bmc0/lm3886_amp_balanced_input/lm3886_amp_balanced_input/lm3886_amp_balanced_input.pdf

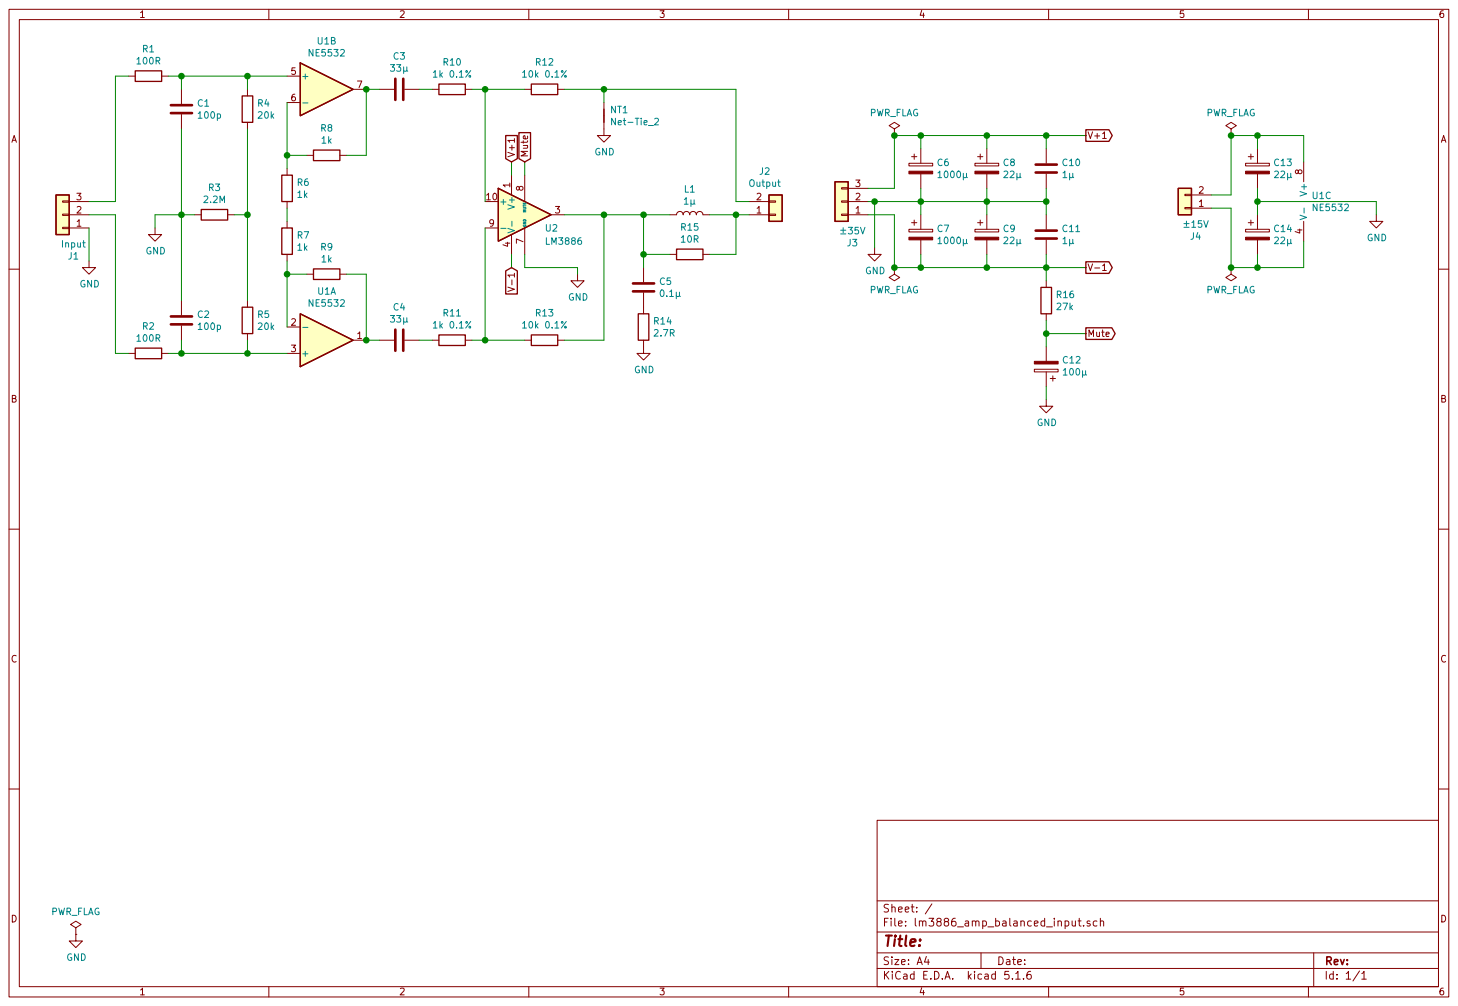
[picture p1: page 1]
