bmc0/lm3886_amp_balanced_input/lm3886_psu/lm3886_psu.pdf

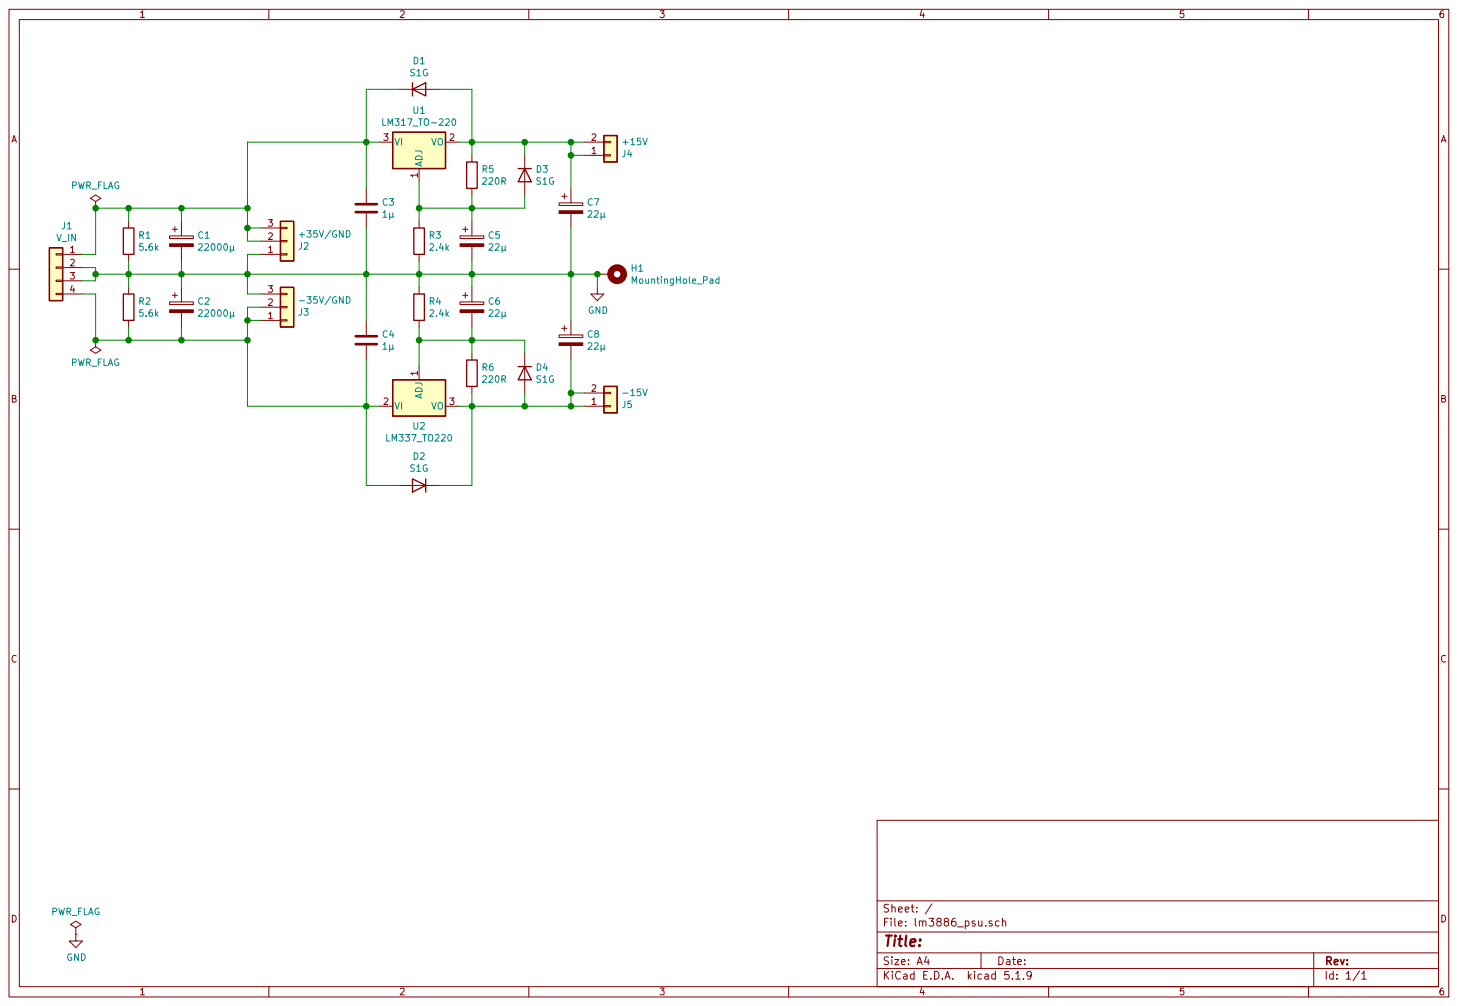
[picture p2: page 1]
