bmc0/lm3886_amp_balanced_input/lm3886_psu_4ch/lm3886_psu_4ch.pdf

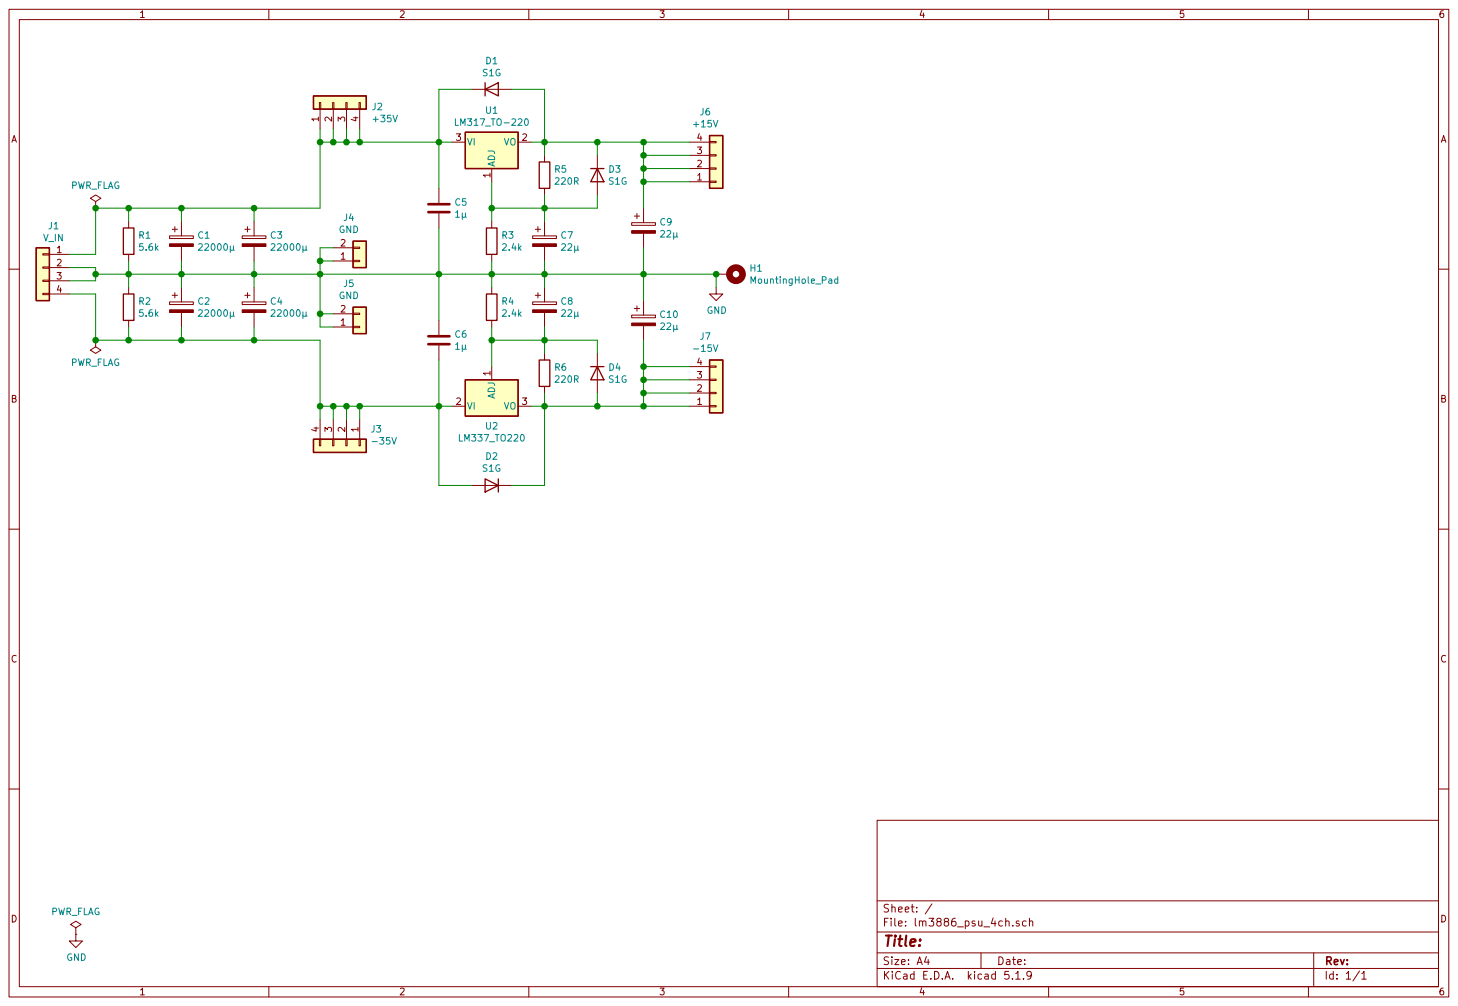
[picture p3: page 1]
