bmc0/lm3886_amp_balanced_input/lm3886_soft_start_v2/lm3886_soft_start_v2.pdf

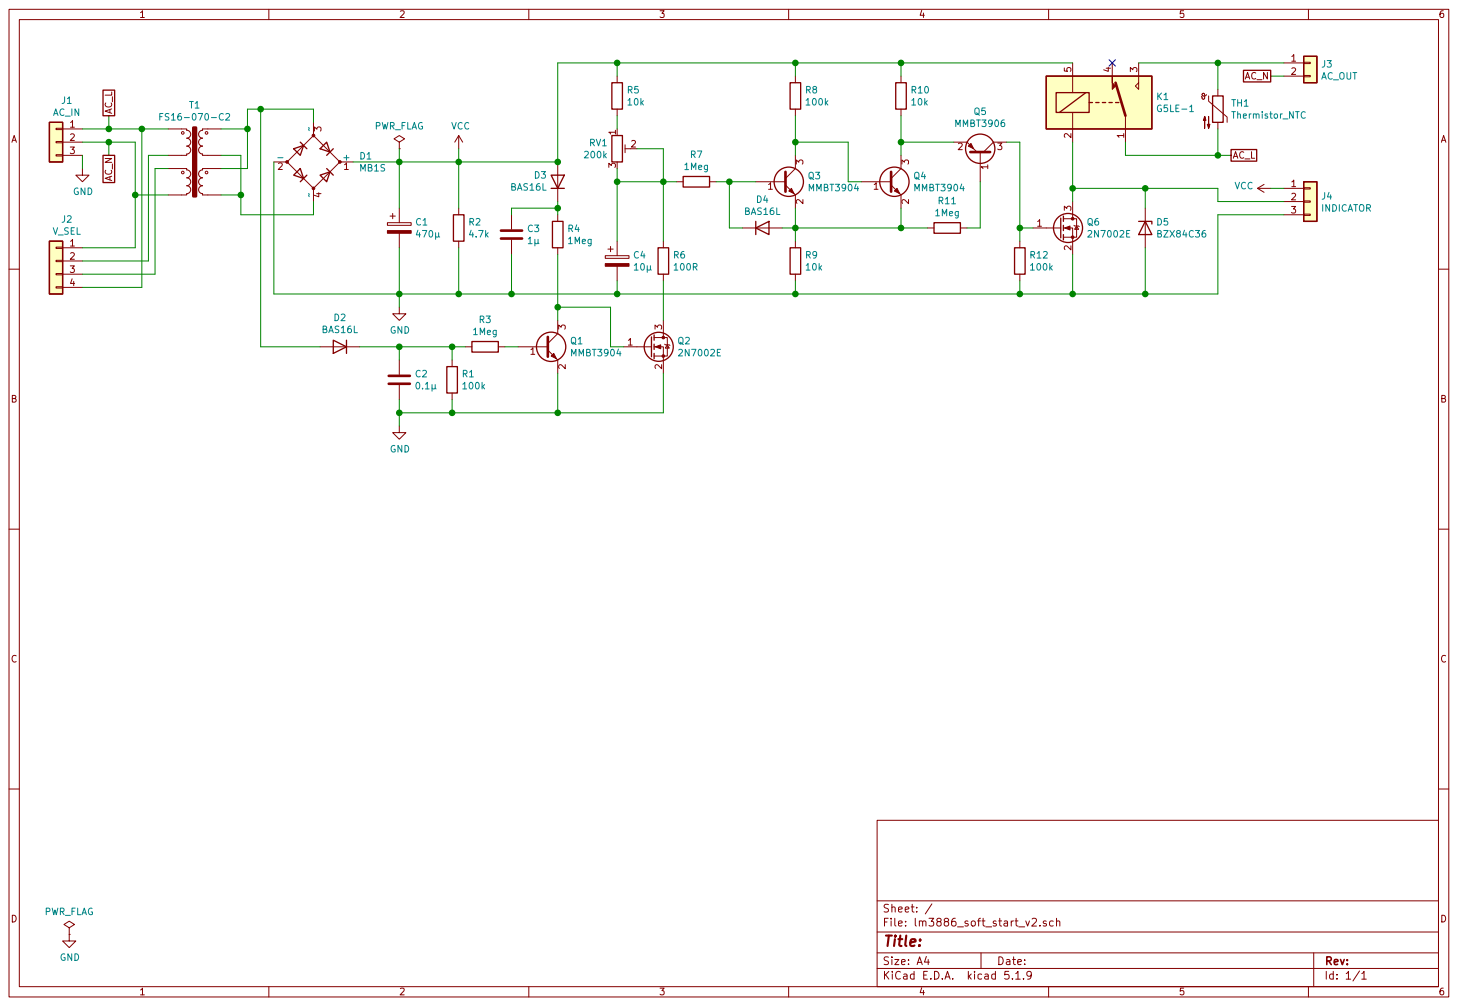
[picture p4: page 1]
