bmc0/lm3886_amp_balanced_input/lm3886_soft_start_v2/lm3886_soft_start_v2.kicad_pcb

## KiCad design lm3886_soft_start_v2/lm3886_soft_start_v2.kicad_pcb (2021-04-19)

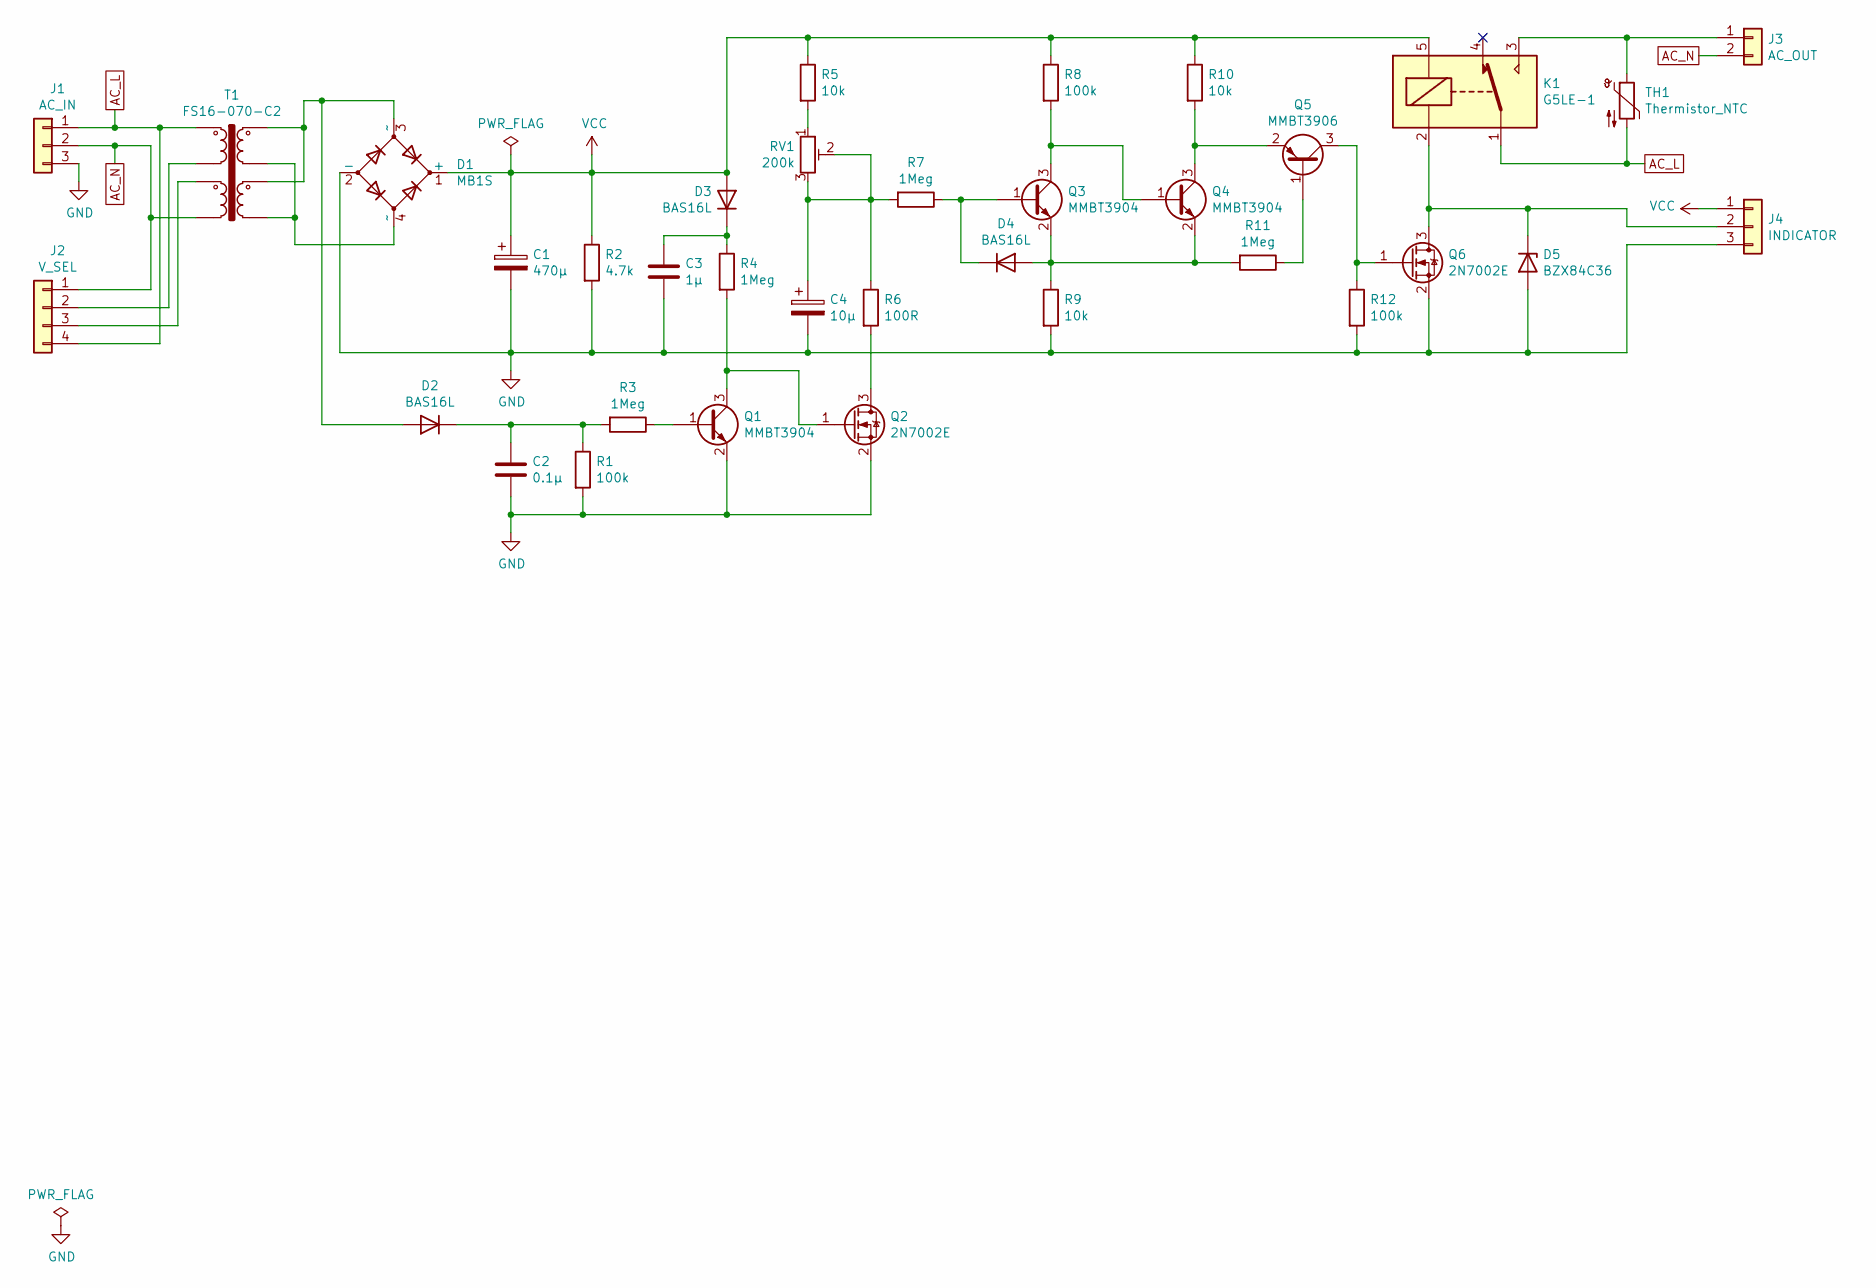
[picture p8: schematic lm3886_soft_start_v2.sch]

Parts:
C1: 470µ; CP_Radial_D10.0mm_P5.00mm
C2: 0.1µ; C_0603_1608Metric
C3: 1µ; C_0805_2012Metric
C4: 10µ; CP_Radial_D5.0mm_P2.00mm
D1: MB1S; TO-269AA
D2, D3, D4: BAS16L; D_SOT-23_ANK
D5: BZX84C36; D_SOT-23_ANK
J1: AC_IN; TerminalBlock_Phoenix_PT-1,5-3-5.0-H_1x03_P5.00mm_Horizontal
J2: V_SEL; SolderWire-0.5sqmm_1x04_P4.6mm_D0.9mm_OD2.1mm
J3: AC_OUT; TerminalBlock_Phoenix_PT-1,5-2-5.0-H_1x02_P5.00mm_Horizontal
J4: INDICATOR; PinHeader_1x03_P2.54mm_Vertical
K1: G5LE-1; Relay_SPDT_Omron-G5LE-1
Q1, Q3, Q4: MMBT3904; SOT-23
Q2, Q6: 2N7002E; SOT-23
Q5: MMBT3906; SOT-23
R1, R8, R12: 100k; R_0603_1608Metric
R2: 4.7k; R_1206_3216Metric
R3, R4, R7, R11: 1Meg; R_0603_1608Metric
R5, R9, R10: 10k; R_0603_1608Metric
R6: 100R; R_0603_1608Metric
RV1: 200k; Potentiometer_Nidec_Copal_CT-6EP
T1: FS16-070-C2; Triad_FS16-070-C2
TH1: Thermistor_NTC; NTC_Thermistor_D16mm_P7.5mm

Connections:
AC_L: J1.1, J2.4, K1.1, T1.1, TH1.2
AC_N: J1.2, J2.1, J3.2, T1.4
GND: C1.2, C2.2, C3.2, C4.2, D1.2 (-), D5.2 (A), J1.3, J4.3, Q1.2 (E), Q2.2 (S), Q6.2 (S), R1.2, R2.2, R9.2, R12.2
unnamed: C2.1, D2.1 (K), R1.1, R3.2
unnamed: C3.1, D3.1 (K), R4.1
unnamed: C4.1, R6.1, R7.2, RV1.2, RV1.3
unnamed: D1.3 (~~), D2.2 (A), T1.5, T1.7
unnamed: D1.4 (~~), T1.6, T1.8
unnamed: D4.1 (K), Q3.1 (B), R7.1
unnamed: D4.2 (A), Q3.2 (E), Q4.2 (E), R9.1, R11.2
unnamed: D5.1 (K), J4.2, K1.2, Q6.3 (D)
unnamed: J2.2, T1.2
unnamed: J2.3, T1.3
unnamed: J3.1, K1.3, TH1.1
unnamed: Q1.1 (B), R3.1
unnamed: Q1.3 (C), Q2.1 (G), R4.2
unnamed: Q2.3 (D), R6.2
unnamed: Q3.3 (C), Q4.1 (B), R8.2
unnamed: Q4.3 (C), Q5.2 (E), R10.2
unnamed: Q5.1 (B), R11.1
unnamed: Q5.3 (C), Q6.1 (G), R12.1
unnamed: R5.2, RV1.1
VCC: C1.1, D1.1 (+), D3.2 (A), J4.1, K1.5, R2.1, R5.1, R8.1, R10.1

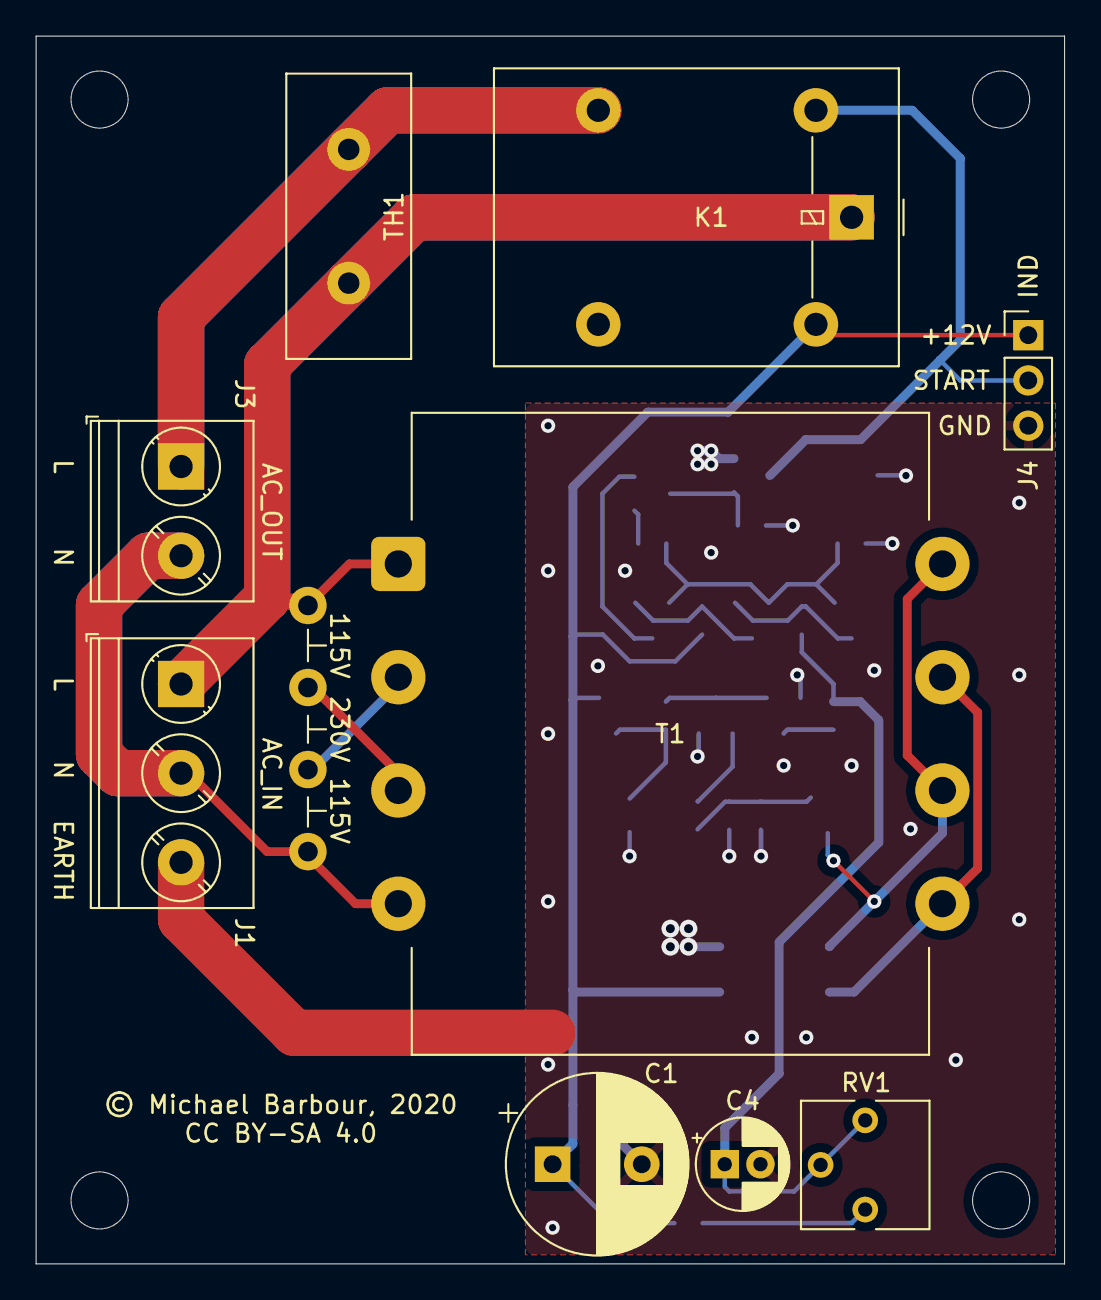
[picture p9: board lm3886_soft_start_v2.kicad_pcb from above]

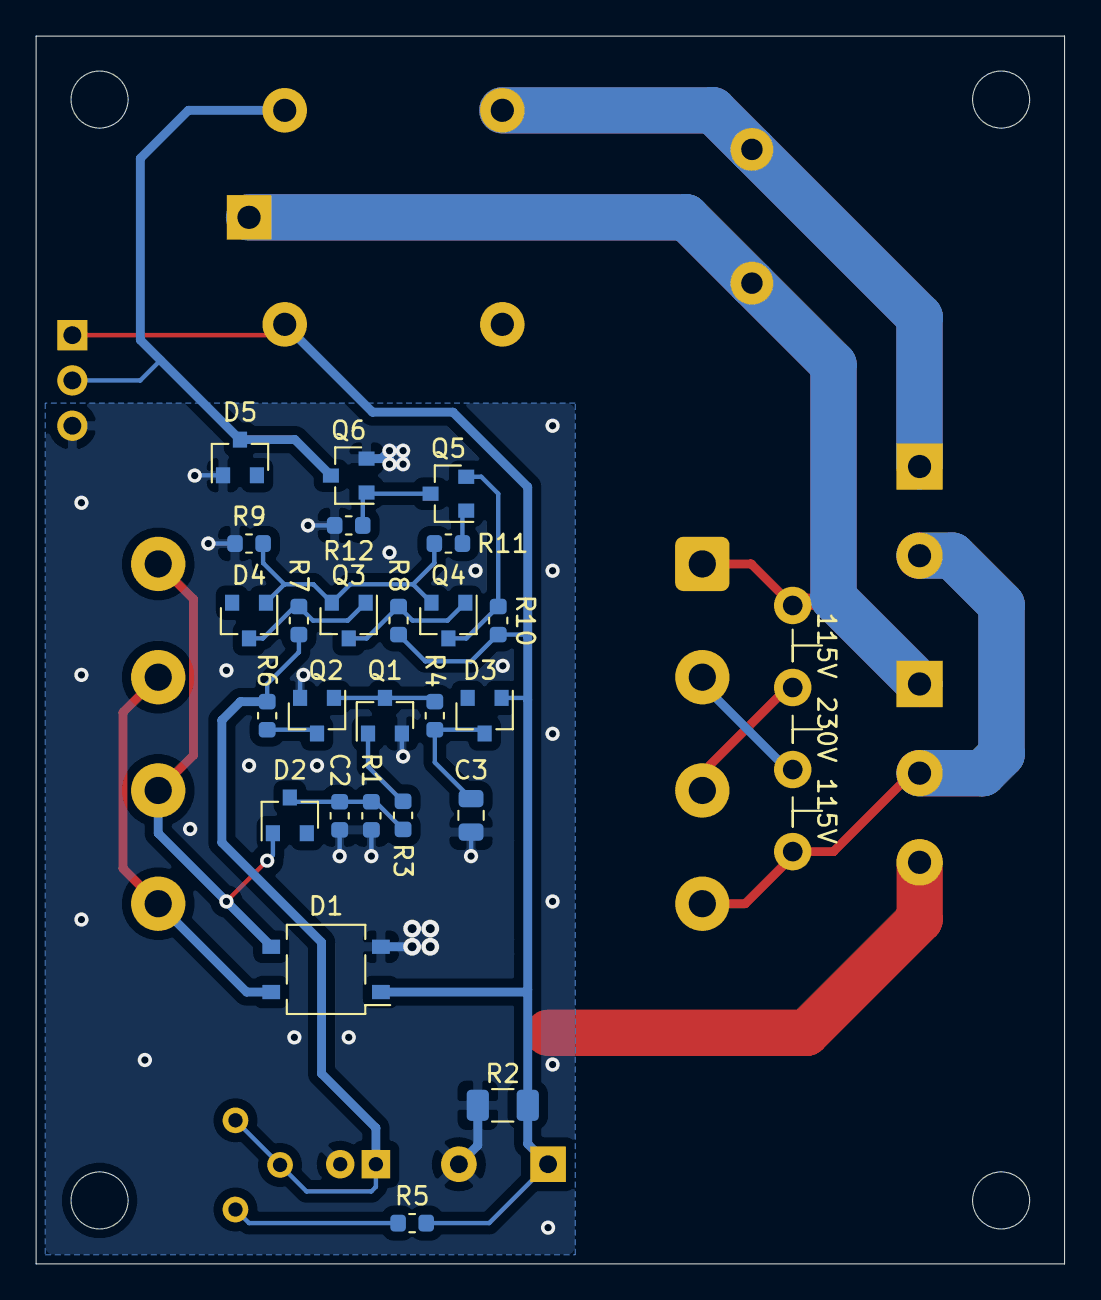
[picture p10: board lm3886_soft_start_v2.kicad_pcb from below]

Board: 2 copper layers, 57.7 x 68.8 mm, 35 parts (25 on the bottom side), 23 nets.
