bmc0/lm3886_amp_balanced_input/lm3886_psu/lm3886_psu.kicad_pcb

## KiCad design lm3886_psu/lm3886_psu.kicad_pcb (2021-04-19)

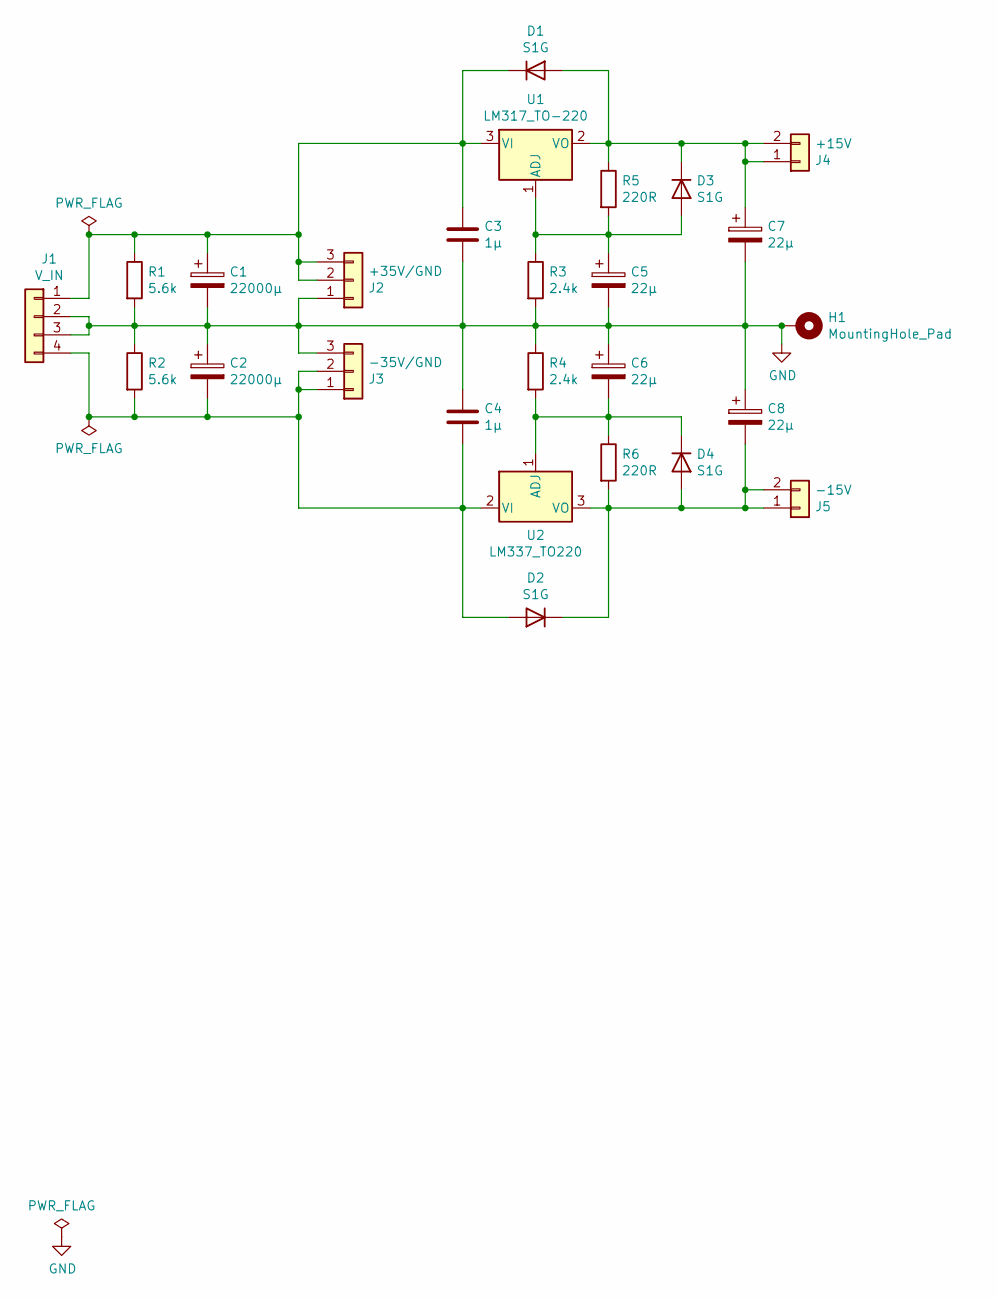
[picture p11: schematic lm3886_psu.sch]

Parts:
C1, C2: 22000µ; CP_Radial_D35.0mm_P10.00mm_SnapIn
C3, C4: 1µ; C_1206_3216Metric
C5, C6, C7, C8: 22µ; CP_Radial_D5.0mm_P2.00mm
D1, D2, D3, D4: S1G; D_SMA
H1: MountingHole_Pad; MountingHole_3.2mm_M3_Pad_Via
J1: V_IN; TerminalBlock_Phoenix_PT-1,5-4-5.0-H_1x04_P5.00mm_Horizontal
J2: +35V/GND; TerminalBlock_Phoenix_PT-1,5-3-5.0-H_1x03_P5.00mm_Horizontal
J3: -35V/GND; TerminalBlock_Phoenix_PT-1,5-3-5.0-H_1x03_P5.00mm_Horizontal
J4: +15V; TerminalBlock_Phoenix_PT-1,5-2-3.5-H_1x02_P3.50mm_Horizontal
J5: -15V; TerminalBlock_Phoenix_PT-1,5-2-3.5-H_1x02_P3.50mm_Horizontal
R1, R2: 5.6k; R_Axial_DIN0411_L9.9mm_D3.6mm_P15.24mm_Horizontal
R3, R4: 2.4k; R_1206_3216Metric
R5, R6: 220R; R_1206_3216Metric
U1: LM317_TO-220; TO-220-3_Vertical
U2: LM337_TO220; TO-220-3_Vertical

Connections:
GND: C1.2, C2.1, C3.2, C4.1, C5.2, C6.1, C7.2, C8.1, H1.1, J1.2, J1.3, J2.1, J3.3, R1.2, R2.1, R3.2, R4.1
unnamed: C1.1, C3.1, D1.1 (K), J1.1, J2.2, J2.3, R1.1, U1.3 (VI)
unnamed: C2.2, C4.2, D2.2 (A), J1.4, J3.1, J3.2, R2.2, U2.2 (VI)
unnamed: C5.1, D3.2 (A), R3.1, R5.2, U1.1 (ADJ)
unnamed: C6.2, D4.1 (K), R4.2, R6.1, U2.1 (ADJ)
unnamed: C7.1, D1.2 (A), D3.1 (K), J4.1, J4.2, R5.1, U1.2 (VO)
unnamed: C8.2, D2.1 (K), D4.2 (A), J5.1, J5.2, R6.2, U2.3 (VO)

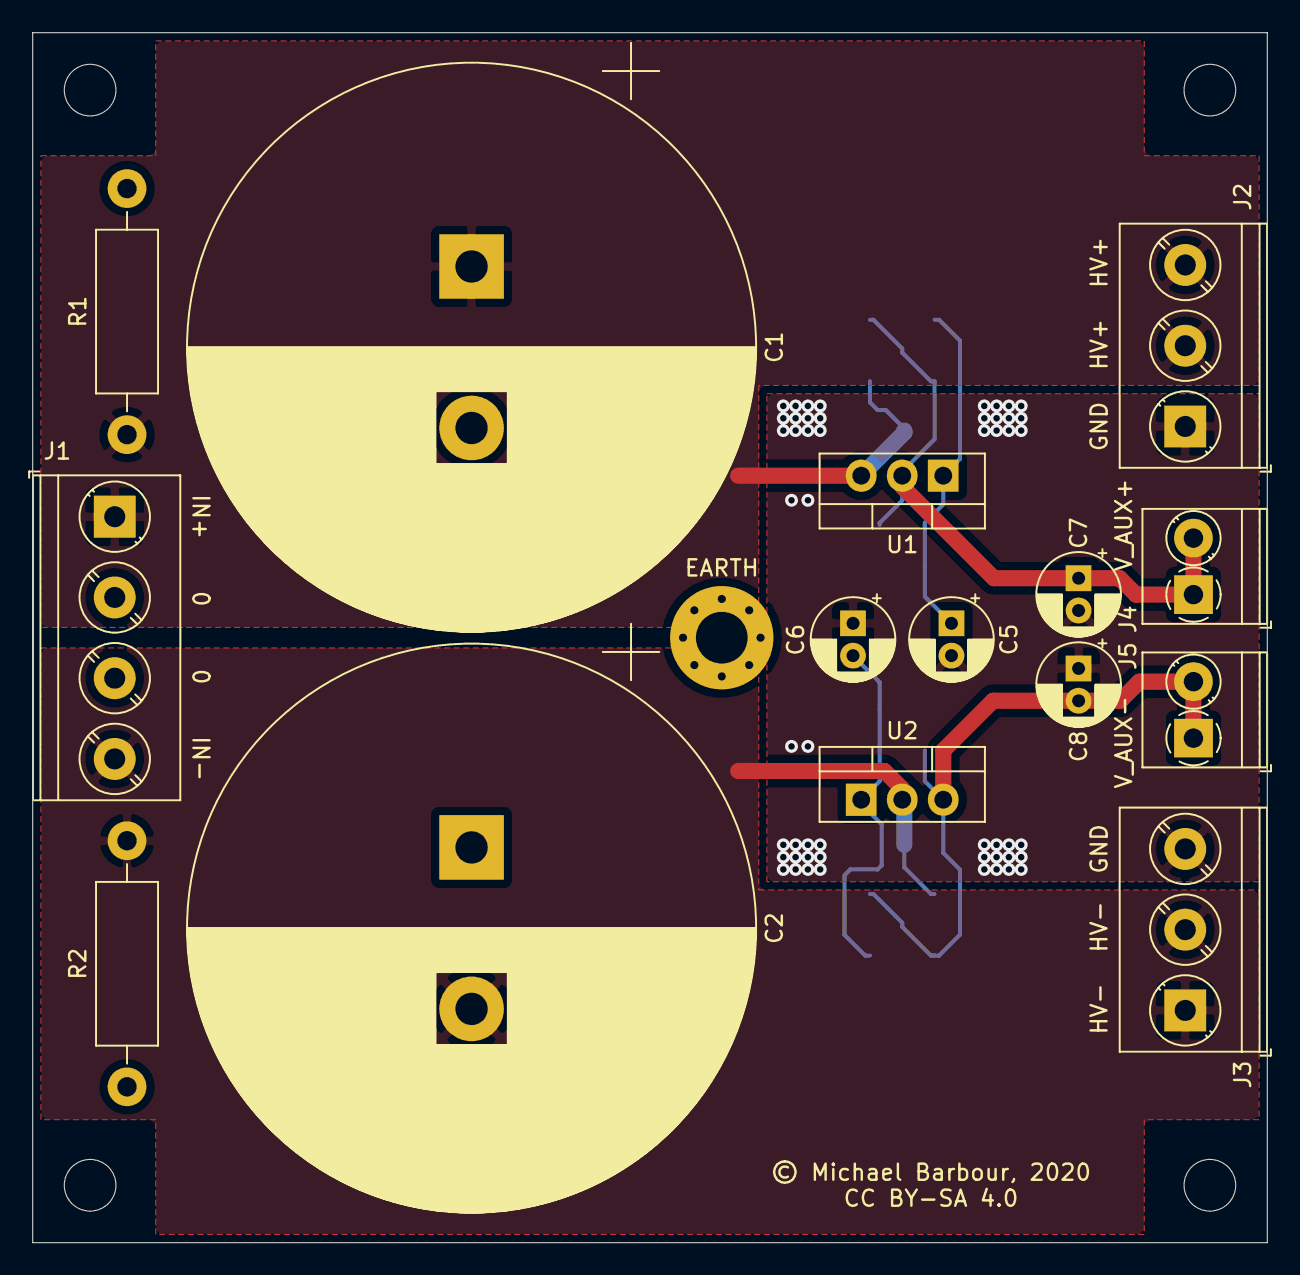
[picture p12: board lm3886_psu.kicad_pcb from above]

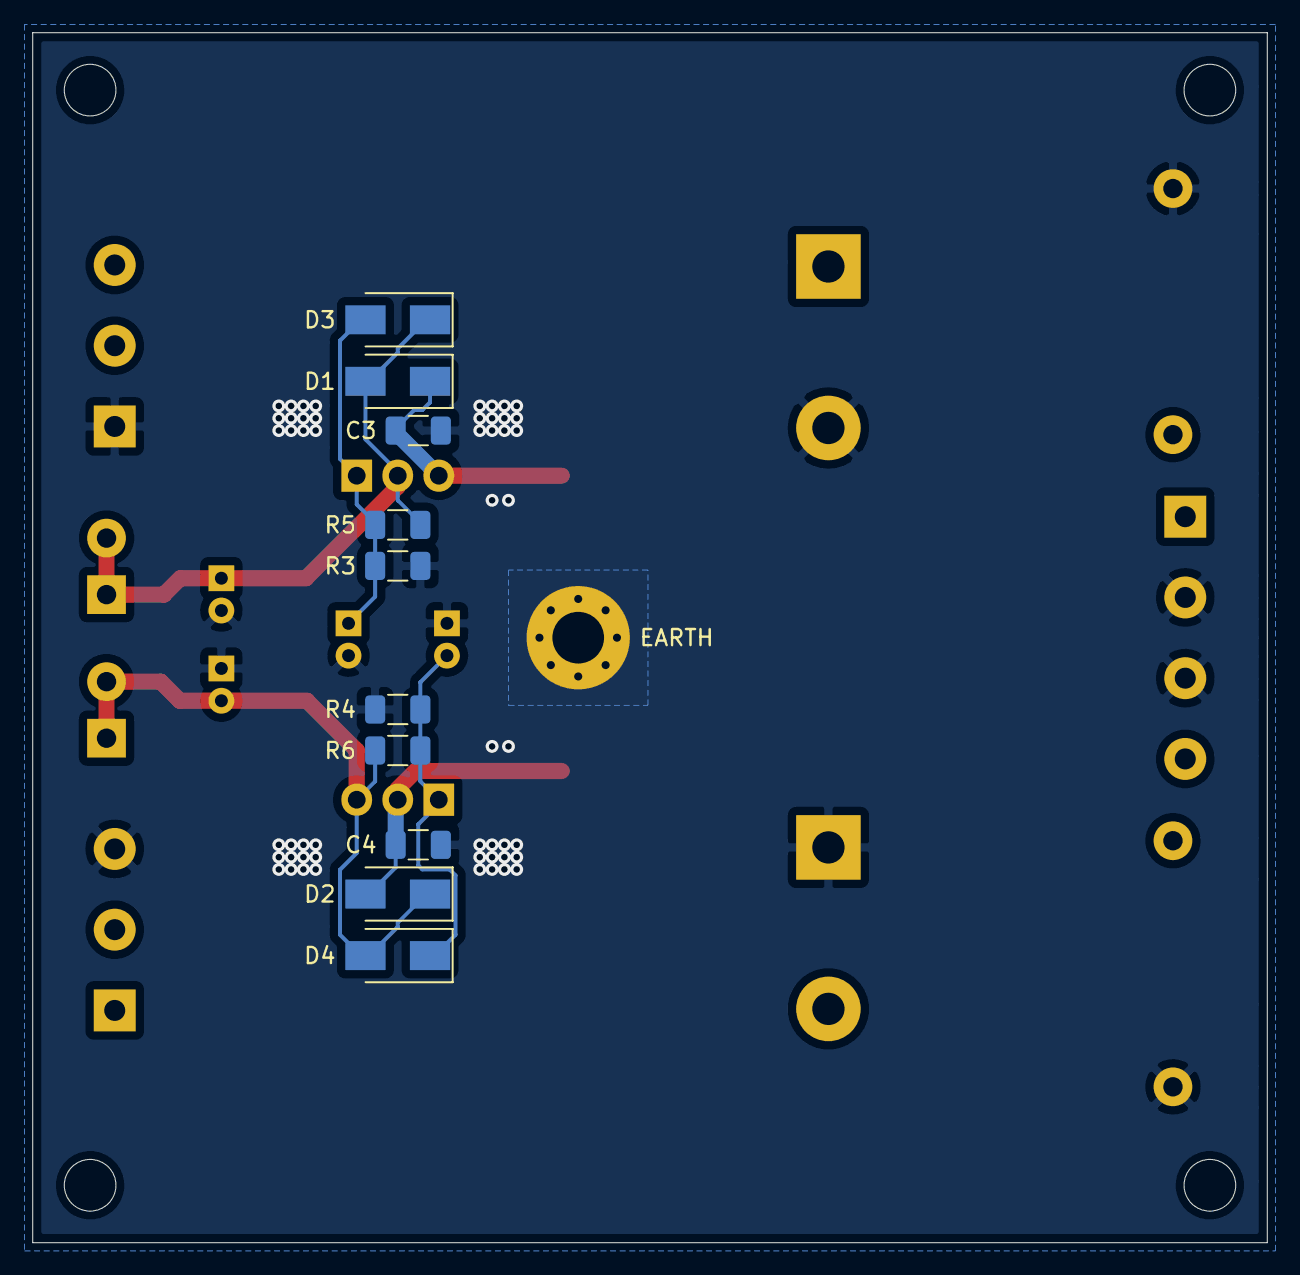
[picture p13: board lm3886_psu.kicad_pcb from below]

Board: 2 copper layers, 76.5 x 74.9 mm, 26 parts (10 on the bottom side), 7 nets.
