bmc0/lm3886_amp_balanced_input/lm3886_amp_balanced_input/lm3886_amp_balanced_input.kicad_pcb

## KiCad design lm3886_amp_balanced_input/lm3886_amp_balanced_input.kicad_pcb (2021-04-19)

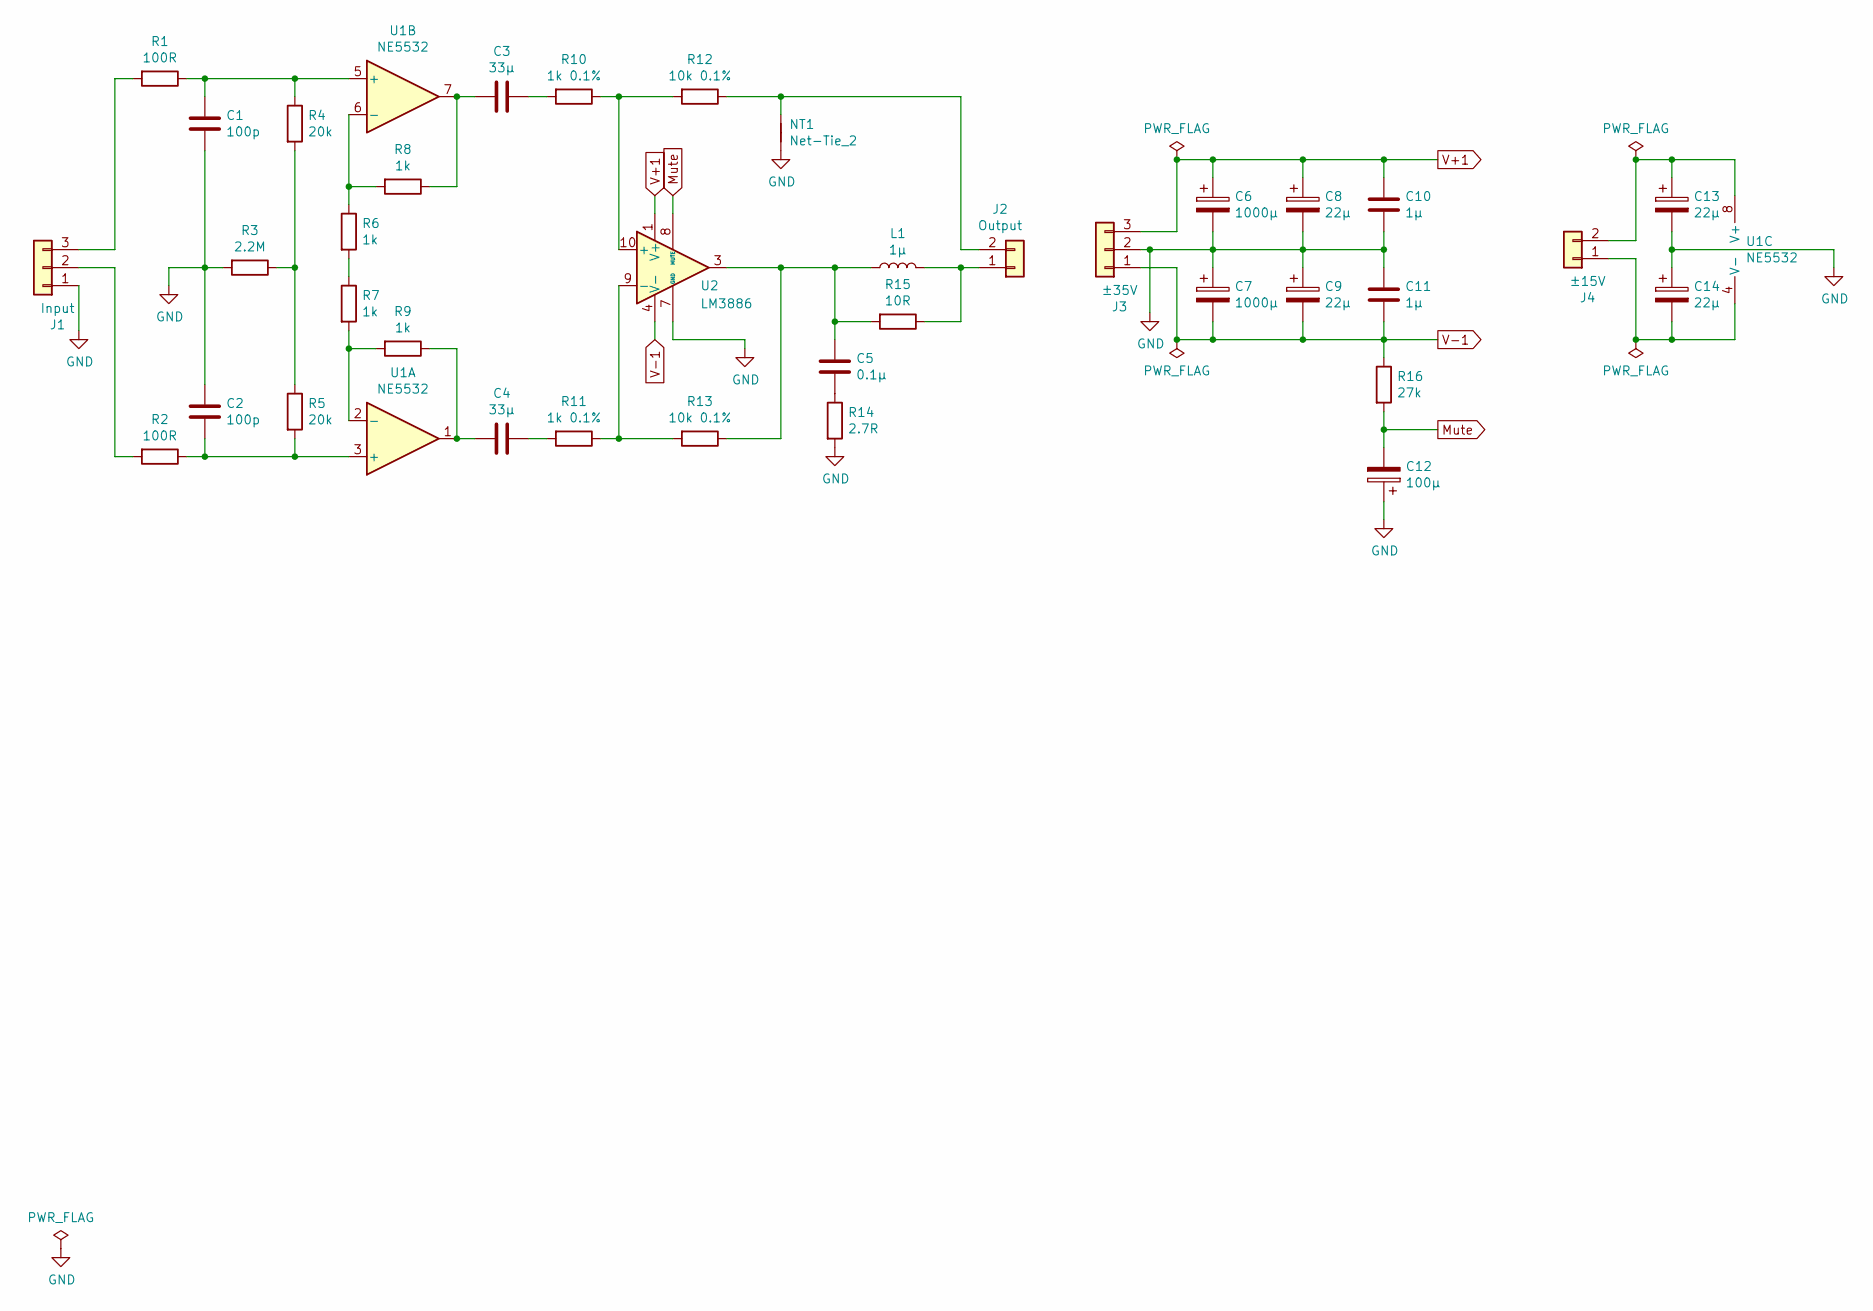
[picture p14: schematic lm3886_amp_balanced_input.sch]

Parts:
C1, C2: 100p; C_0603_1608Metric
C3, C4: 33µ; C_Radial_D6.3mm_H11.0mm_P2.50mm
C5: 0.1µ; C_Rect_L7.2mm_W2.5mm_P5.00mm_FKS2_FKP2_MKS2_MKP2
C6, C7: 1000µ; CP_Radial_D16.0mm_P7.50mm
C8, C9, C13, C14: 22µ; CP_Radial_D5.0mm_P2.00mm
C10, C11: 1µ; C_1206_3216Metric
C12: 100µ; CP_Radial_D5.0mm_P2.00mm
J1: Input; TerminalBlock_Phoenix_PT-1,5-3-3.5-H_1x03_P3.50mm_Horizontal
J2: Output; TerminalBlock_Phoenix_PT-1,5-2-5.0-H_1x02_P5.00mm_Horizontal
J3: ±35V; TerminalBlock_Phoenix_PT-1,5-3-5.0-H_1x03_P5.00mm_Horizontal
J4: ±15V; TerminalBlock_Phoenix_PT-1,5-2-3.5-H_1x02_P3.50mm_Horizontal
L1: 1µ; lm3886_output_inductor_1µH
NT1: Net-Tie_2; NetTie-2_SMD_Pad2.0mm
R1, R2: 100R; R_0603_1608Metric
R3: 2.2M; R_0603_1608Metric
R4, R5: 20k; R_0603_1608Metric
R6, R7, R8, R9: 1k; R_0603_1608Metric
R10, R11: 1k 0.1%; R_0805_2012Metric
R12, R13: 10k 0.1%; R_0805_2012Metric
R14: 2.7R; R_Axial_DIN0411_L9.9mm_D3.6mm_P12.70mm_Horizontal
R15: 10R; R_Axial_DIN0411_L9.9mm_D3.6mm_P12.70mm_Horizontal
R16: 27k; R_0805_2012Metric
U1: NE5532; SOIC-8_3.9x4.9mm_P1.27mm
U2: LM3886; TO-220-11_P3.4x5.08mm_StaggerOdd_Lead4.85mm_Vertical_LM3886

Connections:
GND: C1.2, C2.1, C6.2, C7.1, C8.2, C9.1, C10.2, C11.1, C12.1, C13.2, C14.1, J1.1, J3.2, NT1.2, R3.2, R14.2, U2.7 (GND)
Mute: C12.2, R16.2, U2.8 (MUTE)
unnamed: C1.1, R1.1, R4.1, U1.5 (+)
unnamed: C2.2, R2.1, R5.2, U1.3 (+)
unnamed: C3.1, R10.2
unnamed: C3.2, R8.1, U1.7
unnamed: C4.1, R11.2
unnamed: C4.2, R9.1, U1.1
unnamed: C5.1, L1.1, R13.1, R15.2, U2.3
unnamed: C5.2, R14.1
unnamed: C13.1, J4.2, U1.8 (V+)
unnamed: C14.2, J4.1, U1.4 (V-)
unnamed: J1.2, R2.2
unnamed: J1.3, R1.2
unnamed: J2.1, L1.2, R15.1
unnamed: J2.2, NT1.1, R12.1
unnamed: R3.1, R4.2, R5.1
unnamed: R6.1, R8.2, U1.6 (-)
unnamed: R6.2, R7.1
unnamed: R7.2, R9.2, U1.2 (-)
unnamed: R10.1, R12.2, U2.10 (+)
unnamed: R11.1, R13.2, U2.9 (-)
V+1: C6.1, C8.1, C10.1, J3.3, U2.1 (V+), U2.5 (V+)
V-1: C7.2, C9.2, C11.2, J3.1, R16.1, U2.4 (V-)

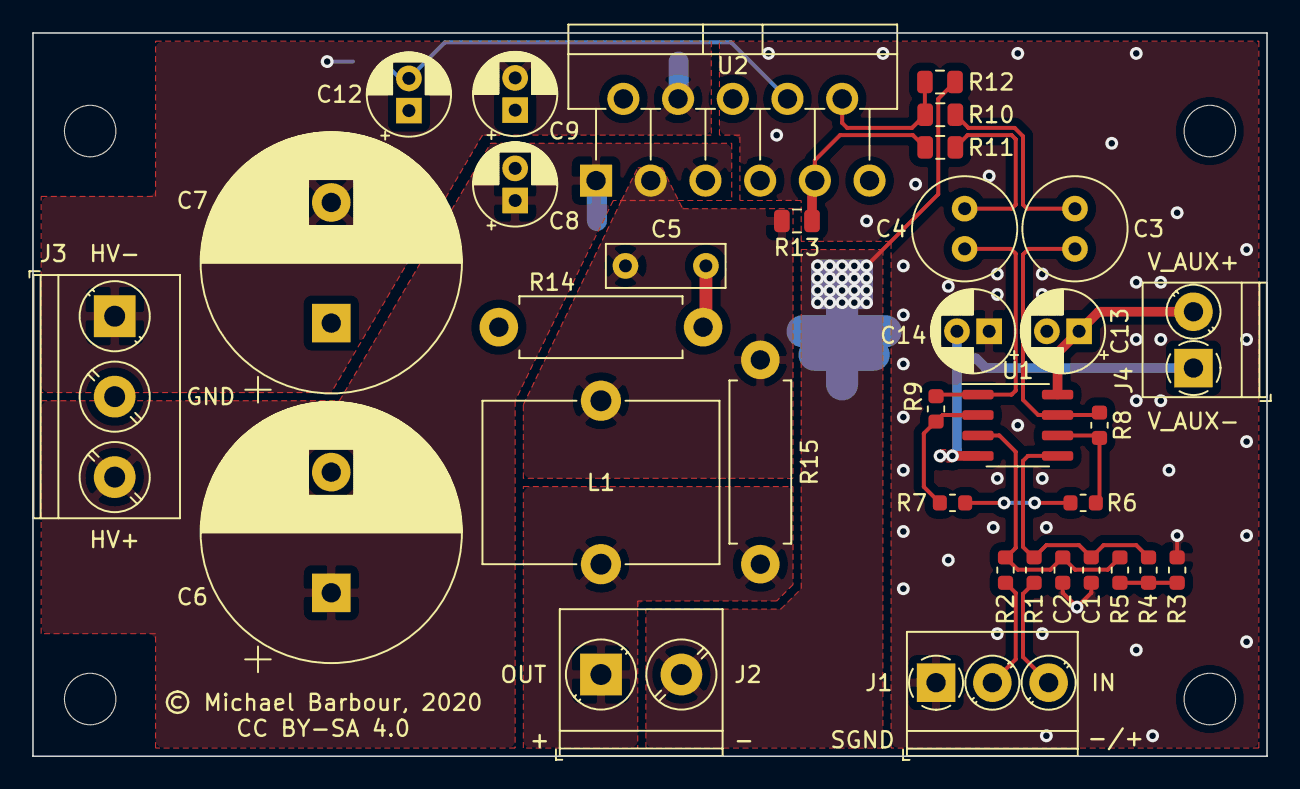
[picture p15: board lm3886_amp_balanced_input.kicad_pcb from above]

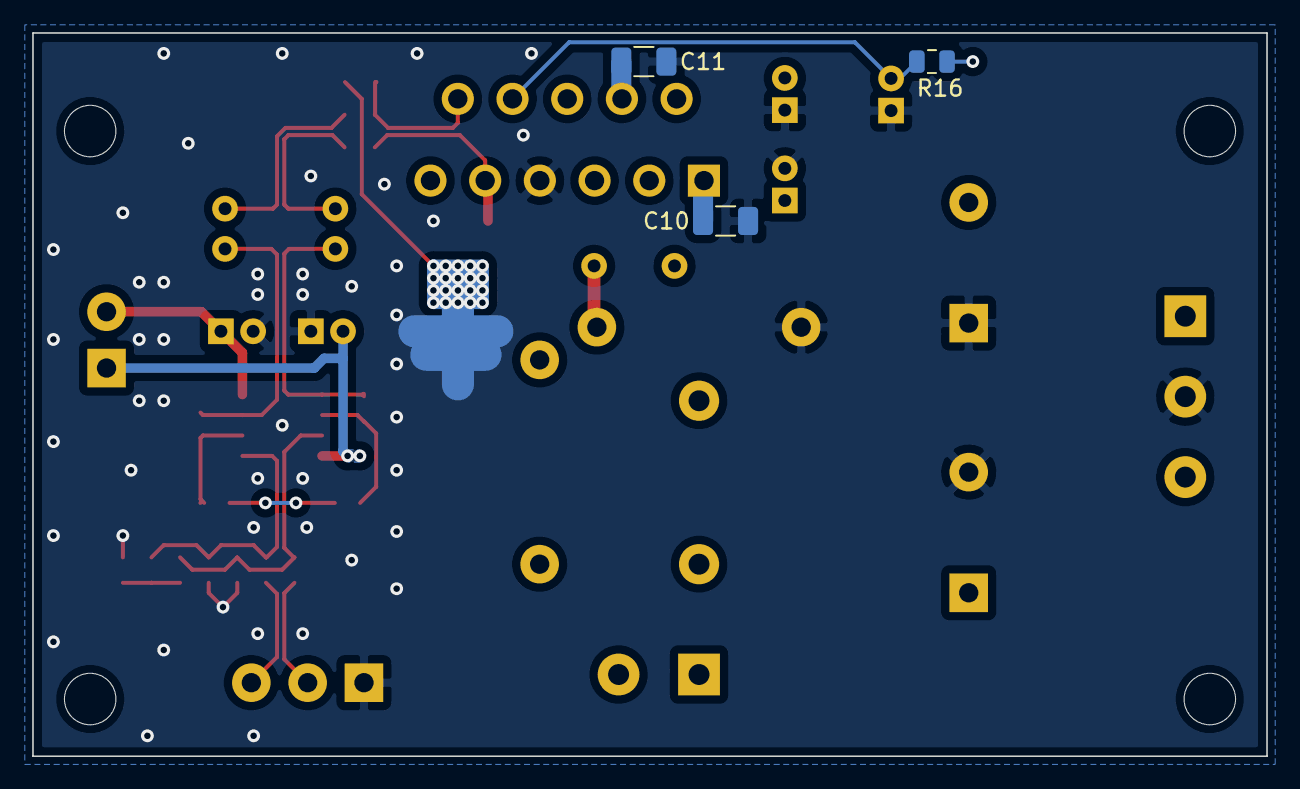
[picture p16: board lm3886_amp_balanced_input.kicad_pcb from below]

Board: 2 copper layers, 76.7 x 45.0 mm, 38 parts (4 on the bottom side), 24 nets.
