bmc0/lm3886_amp_balanced_input/(notices)

Notices in the files:
lm3886_amp_balanced_input/lm3886_amp_balanced_input.kicad_pcb:
© Michael Barbour, 2020
CC BY-SA 4.0
